Sakhiyuvio/Any-Screen-to-Touch-Screen/README.md

# Any-Screen-to-Touch-Screen

Making any screen of any device to become touch-screen. Utilizing UWB transceivers for location distinction with triangulation and TWR algorithms. Our pen enclosure communicates to host device via Bluetooth HID.
