Sakhiyuvio/Any-Screen-to-Touch-Screen/Any-Screen-Touch-Screen_PowerMS/Any-Screen-Touch-Screen_AnchorMod.kicad_pcb

## KiCad design Any-Screen-Touch-Screen_PowerMS/Any-Screen-Touch-Screen_AnchorMod.kicad_pcb (2024-10-21)

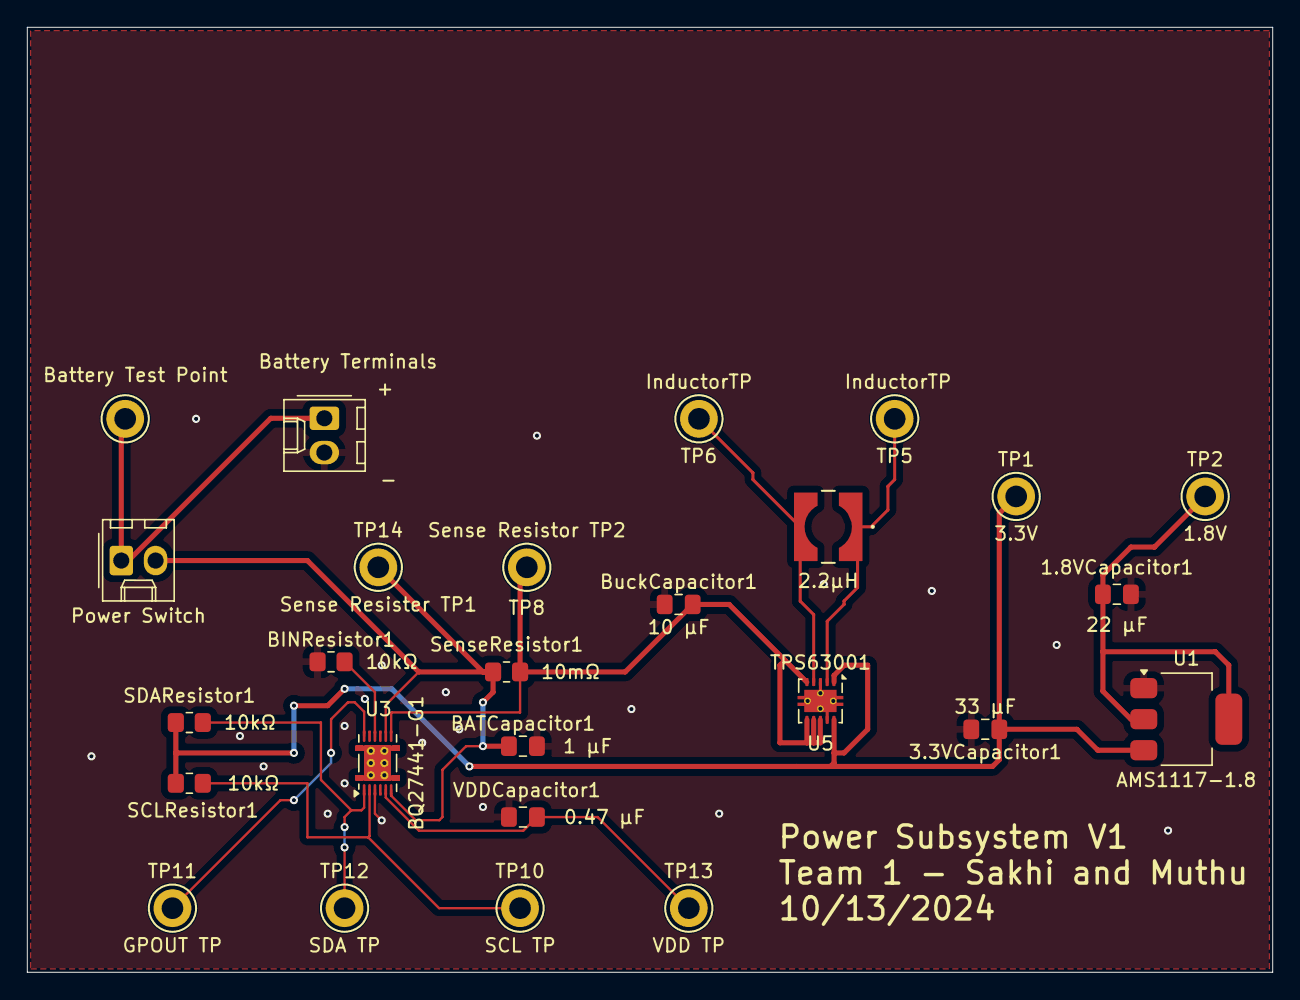
[picture p3: board Any-Screen-Touch-Screen_PowerMS/Any-Screen-Touch-Screen_AnchorMod.kic… from above]

Board: 2 copper layers, 92.2 x 70.0 mm, 26 parts (0 on the bottom side), 13 nets.

Parts:
1.8VCapacitor1: 22 μF; C_0805_2012Metric_Pad1.18x1.45mm_HandSolder
3.3VCapacitor1: 33 μF; C_0805_2012Metric_Pad1.18x1.45mm_HandSolder
BATCapacitor1: 1 μF; C_0805_2012Metric_Pad1.18x1.45mm_HandSolder
BINResistor1: 10kΩ; R_0805_2012Metric_Pad1.20x1.40mm_HandSolder
BuckCapacitor1: 10 μF; C_0805_2012Metric_Pad1.18x1.45mm_HandSolder
J3: Power Switch; Molex_KK-254_AE-6410-02A_1x02_P2.54mm_Vertical
J4: Battery Terminals; Molex_KK-254_AE-6410-02A_1x02_P2.54mm_Vertical
L1: 2.2μH; IND_MSS5131_COC
SCLResistor1: 10kΩ; R_0805_2012Metric_Pad1.20x1.40mm_HandSolder
SDAResistor1: 10kΩ; R_0805_2012Metric_Pad1.20x1.40mm_HandSolder
SenseResistor1: 10mΩ; R_0805_2012Metric_Pad1.20x1.40mm_HandSolder
TP1: 3.3V; TestPoint_Keystone_5010-5014_Multipurpose
TP2: 1.8V; TestPoint_Keystone_5010-5014_Multipurpose
TP3: Battery Test Point; TestPoint_Keystone_5010-5014_Multipurpose
TP5, TP6: InductorTP; TestPoint_Keystone_5010-5014_Multipurpose
TP8: Sense Resistor TP2; TestPoint_Keystone_5010-5014_Multipurpose
TP10: SCL TP; TestPoint_Keystone_5010-5014_Multipurpose
TP11: GPOUT TP; TestPoint_Keystone_5010-5014_Multipurpose
TP12: SDA TP; TestPoint_Keystone_5010-5014_Multipurpose
TP13: VDD TP; TestPoint_Keystone_5010-5014_Multipurpose
TP14: Sense Resister TP1; TestPoint_Keystone_5010-5014_Multipurpose
U1: AMS1117-1.8; SOT-223-3_TabPin2
U3: BQ27441-G1; Texas_S-PDSO-N12
U5: TPS63001; Texas_DRC0010J_ThermalVias
VDDCapacitor1: 0.47 μF; C_0805_2012Metric_Pad1.18x1.45mm_HandSolder

Connections:
GND: 1.8VCapacitor1.2, 3.3VCapacitor1.2, BATCapacitor1.2, BINResistor1.1, BuckCapacitor1.1, J4.2, U1.1 (GND), U3.3 (V_{SS}), U5.3 (PGND), U5.9 (GND), U5.11 (PGND), VDDCapacitor1.2
unnamed: J3.1, J4.1, TP3.1
unnamed: BATCapacitor1.1, J3.2, SenseResistor1.1, TP14.1, U3.6 (BAT), U3.8 (SRP)
unnamed: 3.3VCapacitor1.1, SCLResistor1.1, SDAResistor1.1, TP1.1, U1.3 (VI), U5.1 (VOUT), U5.10 (FB)
unnamed: 1.8VCapacitor1.1, TP2.1, U1.2 (VO)
unnamed: BINResistor1.2, U3.10 (BIN)
unnamed: TP11.1, U3.12 (GPOUT)
unnamed: SCLResistor1.2, TP10.1, U3.2 (SCL)
unnamed: SDAResistor1.2, TP12.1, U3.1 (SDA)
unnamed: BuckCapacitor1.2, SenseResistor1.2, TP8.1, U3.7 (SRN), U5.5 (VIN), U5.6 (EN), U5.7 (PS/SYNC), U5.8 (VINA)
unnamed: TP13.1, U3.5 (V_{DD}), VDDCapacitor1.1
unnamed: L1.2, TP6.1, U5.4 (L1)
unnamed: L1.1, TP5.1, U5.2 (L2)
