Sakhiyuvio/Any-Screen-to-Touch-Screen/fw_tests/uwb_test.ino

#include <SPI.h>
#include "DW1000Ranging.h"

#define ANCHOR_ADDR "86:17:5B:D5:A9:9A:E2:9F" // for testing purpose

// STM32 pin config, devkit
#define SPI_SCLK
#define SPI_MISO
#define SPI_MOSI

// under dev 
