Sakhiyuvio/Any-Screen-to-Touch-Screen/(commit log)

2024-10-03 Anchor and Pen Kicad Designs
    [Any-Screen-Touch-Screen_AnchorMod.kicad_sch, Any-Screen-Touch-Screen_Pen.kicad_sch]
2024-10-03 pcb designs
    [Any-Screen-Touch-Screen_AnchorMod.kicad_pcb, Any-Screen-Touch-Screen_Pen.kicad_pcb]
2024-10-07 pen firmware prog, update on anchor looping
    [Any-Screen-Touch-Screen_AnchorMod.kicad_sch]
2024-10-21 updated pcb design
    [Any-Screen-Touch-Screen_AnchorMod.kicad_pcb, Any-Screen-Touch-Screen_AnchorMod.kicad_sch]
2024-10-30 complementary filter imp
2024-11-05 added fw testing, fixed some typos and clean ups
    [GUI_test.py, MainWindow.py, ble_test.ino, imu_test.ino, pen_control.ino, uwb_anchor1_comm.ino, uwb_anchor2_comm.ino, uwb_test.ino]
2024-11-06 changes to imu testing
2024-11-07 verified imu
2024-11-21 antenna calibration + multi-ranging tag anchor comm
2024-11-21 anchor short address modif
    [pen_control.ino, uwb_test_tag.ino]
2024-11-24 anchor auto-calibration done
2024-11-25 small button testing
2024-11-25 pen button tested
2024-11-27 smoothing filter for uwb
2024-12-01 battery gauge firmware
2024-12-04 working code, integrating battery gauge
2024-12-09 added battery tracking code to anchor firmware
